isadora-fernanda/doglight-monitor-aerogerador/(list of files, drawings)

Other design files:
simulacao/doglight-parte1.ms14
simulacao/doglight.ms14
