isadora-fernanda/doglight-monitor-aerogerador/(commit log)

2026-10-14 Adiciona projeto Doglight de eletrônica analógica (2019)
    Monitor de tensão para aerogeradores, desenvolvido em equipe (UTFPR, 2019). Inclui o circuito do Multisim, fotos da montagem, telas da simulação e GIF do teste no laboratório.
    [doglight.ms14]
2026-10-15 Remove foto da fonte de alimentação
2026-10-15 Adiciona simulação da Parte 1
    [doglight-parte1.ms14]
2026-10-15 Melhora o recorte do esquemático do circuito final
